RouseClock/rouseclock.com/README.md

# rouseclock.com

The Rouse website, served by GitHub Pages at https://rouseclock.com.
Generated from the (private) Rouse source repository by tools/publish_site.py; edits made here are overwritten.

Firmware 1.0.0, case v1.1. © 2026 The Tuscany Group, LC. All rights reserved.
