RouseClock/rouseclock.com/img/clock-classic.png

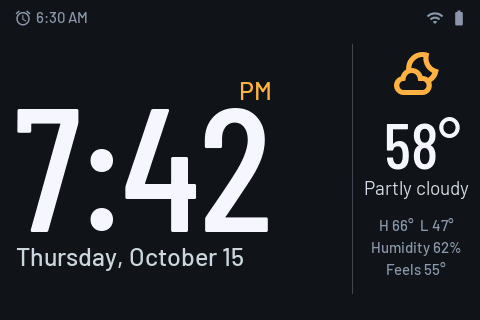
img/clock-classic.png
