RouseClock/rouseclock.com/img/clock-night.png

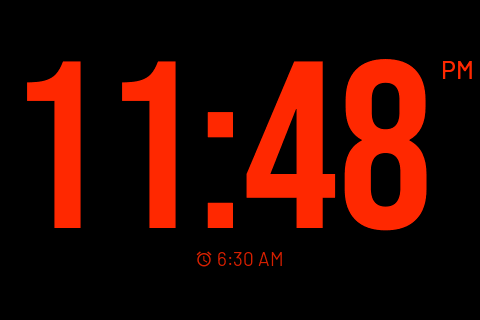
img/clock-night.png
