RouseClock/rouseclock.com/img/clock-photo.png

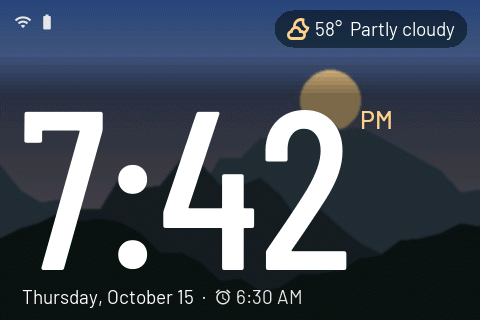
img/clock-photo.png
