RouseClock/rouseclock.com/img/clock-ringing.png

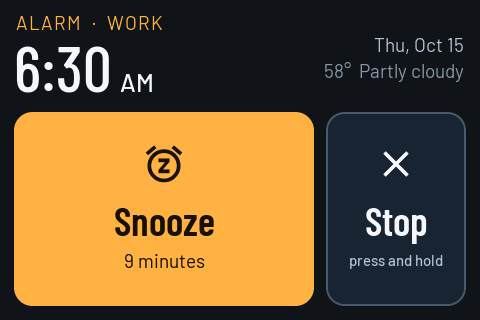
img/clock-ringing.png
