RouseClock/rouseclock.com/img/hero.jpg

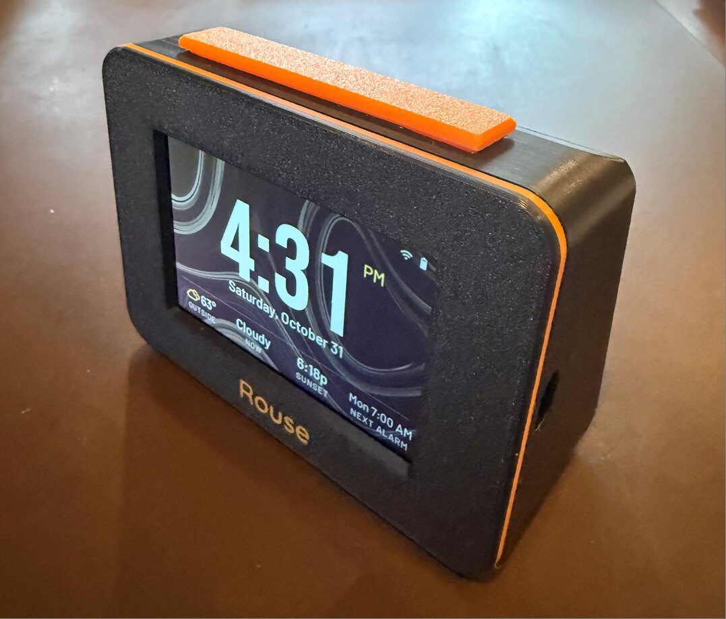
img/hero.jpg
