RouseClock/rouseclock.com/img/night.jpg

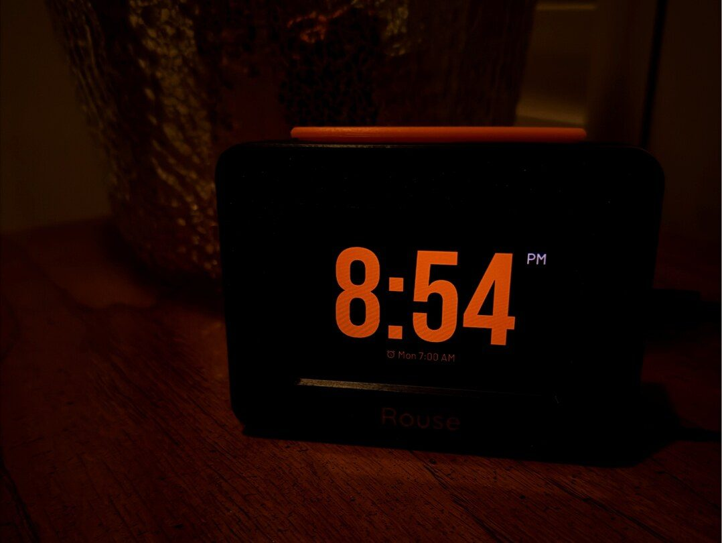
img/night.jpg
