RouseClock/rouseclock.com/img/web-alarms.png

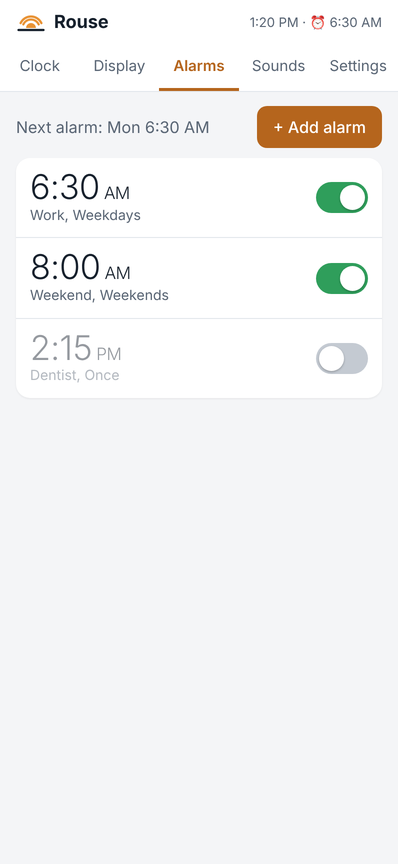
img/web-alarms.png
