RouseClock/rouseclock.com/img/web-display.png

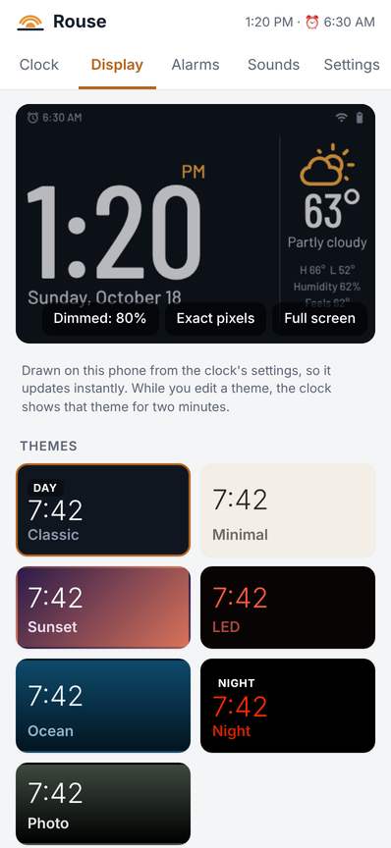
img/web-display.png
