RouseClock/rouseclock.com/img/parts.jpg

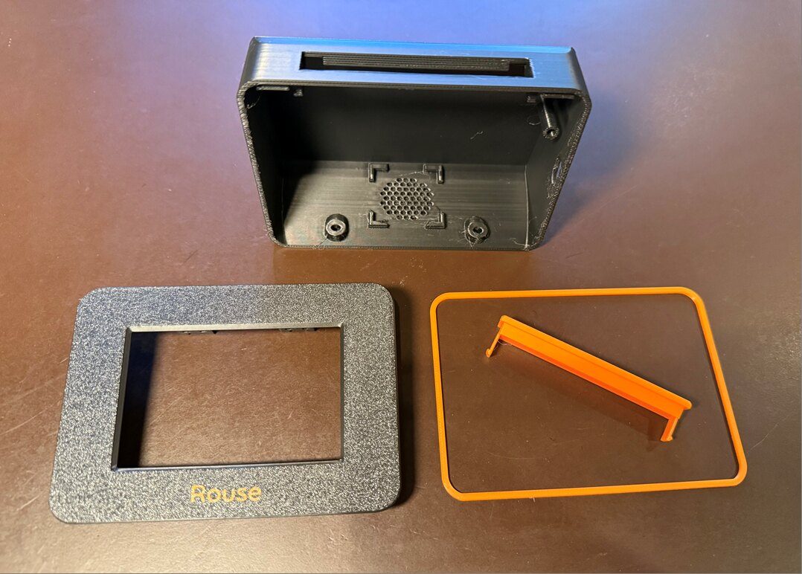
img/parts.jpg
