RouseClock/rouseclock.com/downloads/Rouse-case-v1.1.3mf

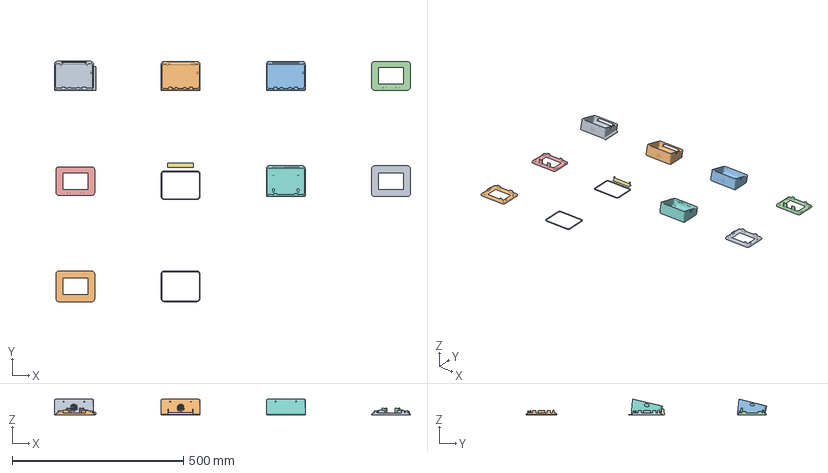
[picture p10: CAD file, 2026-11-05]
downloads/Rouse-case-v1.1.3mf
1039.2 x 702.4 x 46.2 mm
Case with snooze bar opening and stylus holder
Case with snooze bar opening
Case without snooze bar opening
Bezel
Bezel, engraved name
Band ring
Snooze bar
Waveshare case
Waveshare bezel
Waveshare bezel, engraved name
Waveshare band ring
