RouseClock/rouseclock.com/manual/img/clock-wifi.png

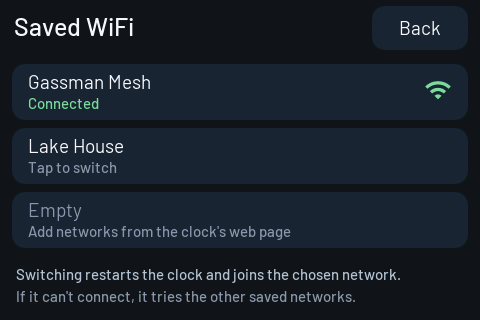
manual/img/clock-wifi.png
