RouseClock/rouseclock.com/(commit log)

2026-11-03 Rouse website: firmware 0.4.3-beta, case v1.1
    Claude-Session: https://claude.ai/code/session_0129qvkwBHLX5DG2GgLeqHQz
    [Rouse-case-v1.1.3mf]
2026-11-05 Case 3MF re-saved in Bambu Studio (complete project, 3 walls, generic PLA)
    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
    [Rouse-case-v1.1.3mf]
2026-11-06 Downloads: case files under CC BY-NC-SA 4.0; firmware terms
    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
